Tecnomobele-FGA/Modulo-luzes/fotos/detalhes_painel_up.jpg

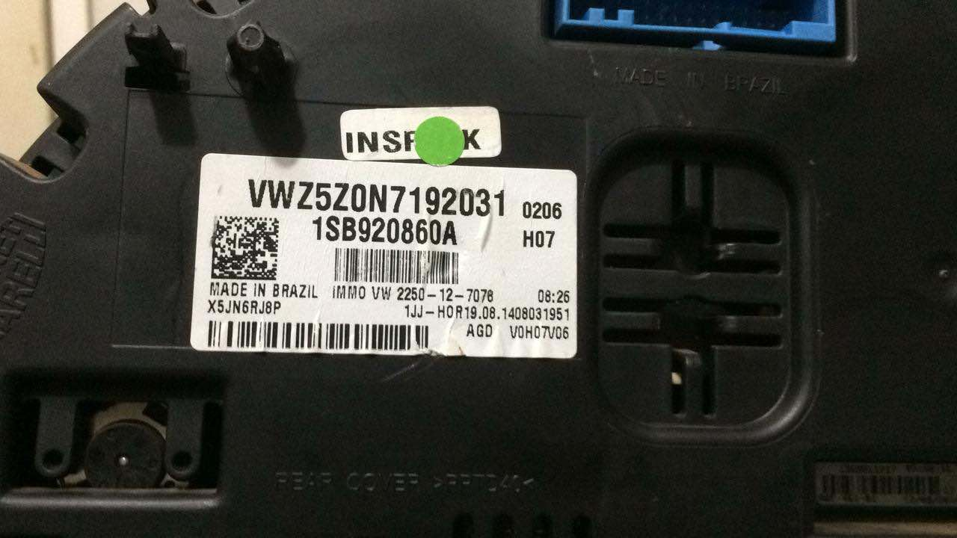
fotos/detalhes_painel_up.jpg
