Tecnomobele-FGA/Modulo-luzes/fotos/painel_up_frente.jpg

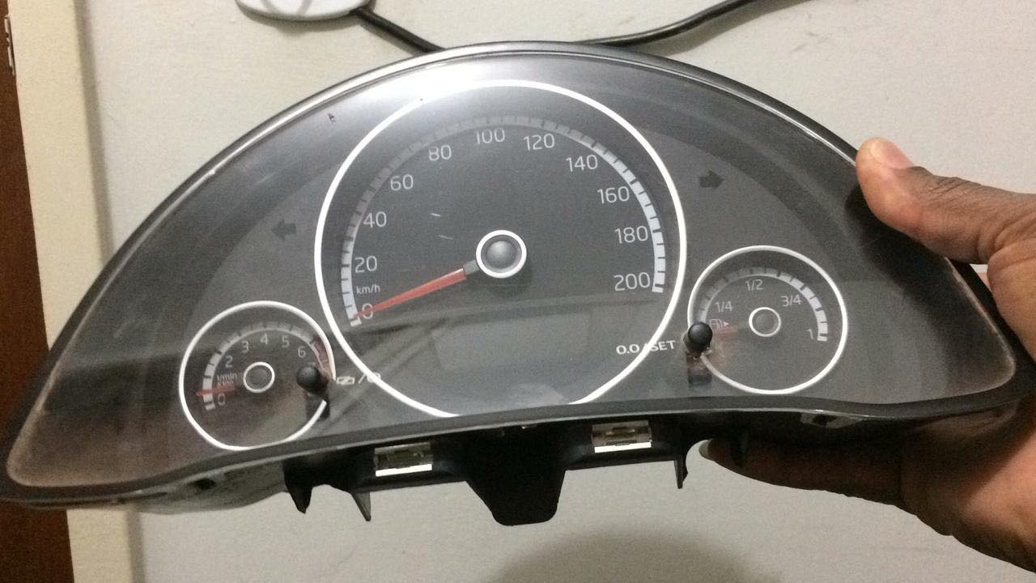
fotos/painel_up_frente.jpg
