Tecnomobele-FGA/Modulo-luzes/fotos/painel_up_fundo.jpg

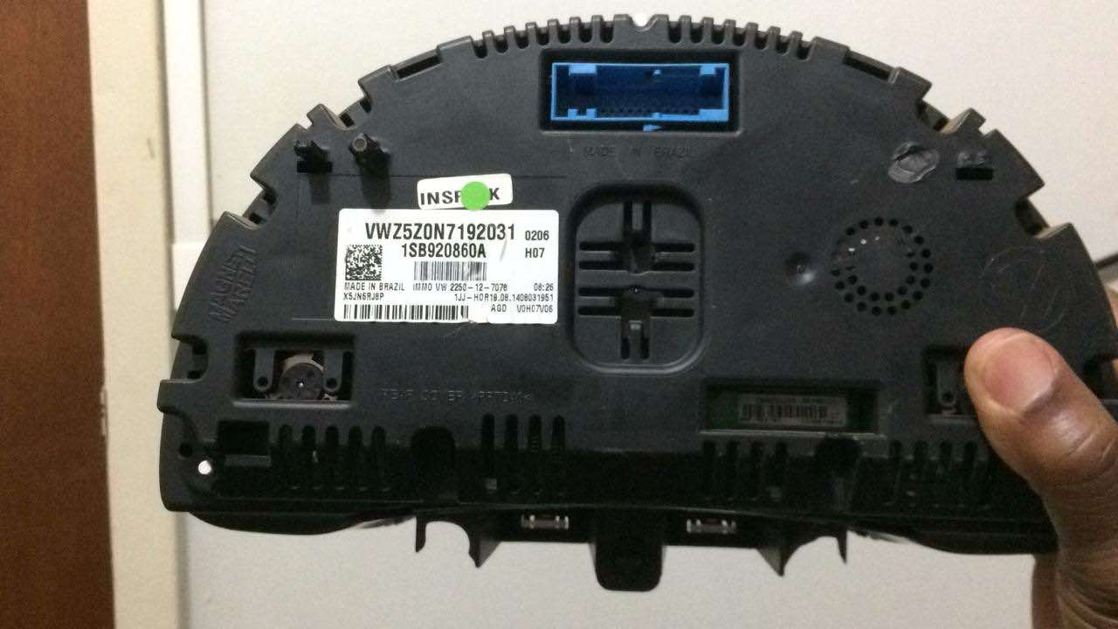
fotos/painel_up_fundo.jpg
