Tecnomobele-FGA/Modulo-luzes/fotos/placa_painel_up.jpg

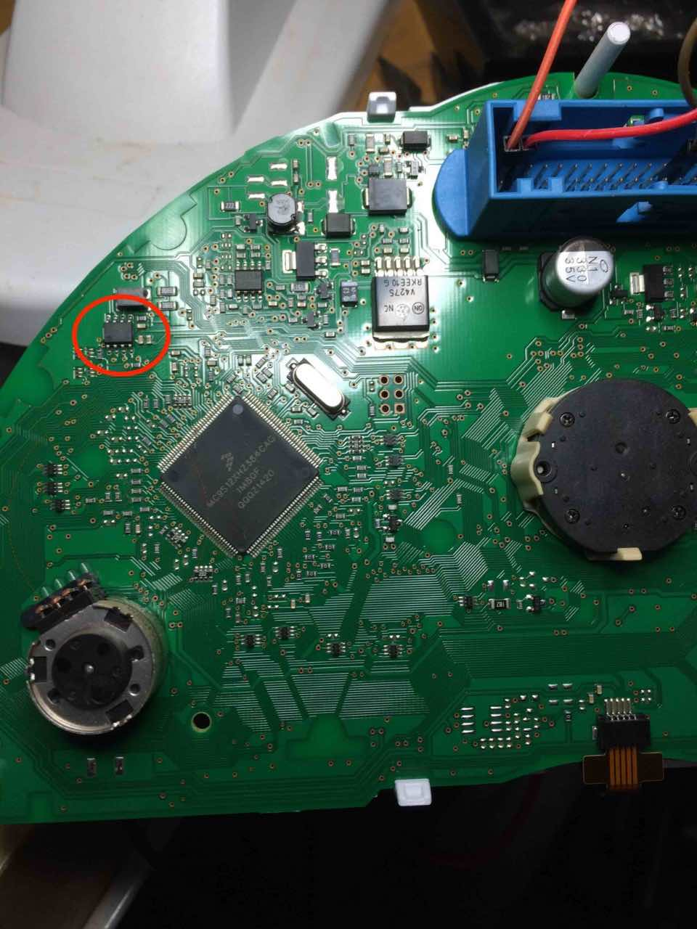
fotos/placa_painel_up.jpg
