Tecnomobele-FGA/Modulo-luzes/fotos/sinal_bloco_1.jpg

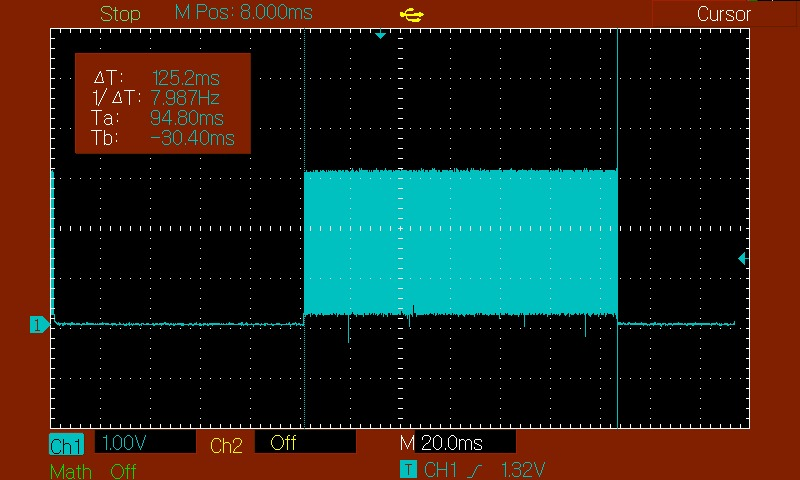
fotos/sinal_bloco_1.jpg
