Tecnomobele-FGA/Modulo-luzes/fotos/sinal_bloco_2.jpg

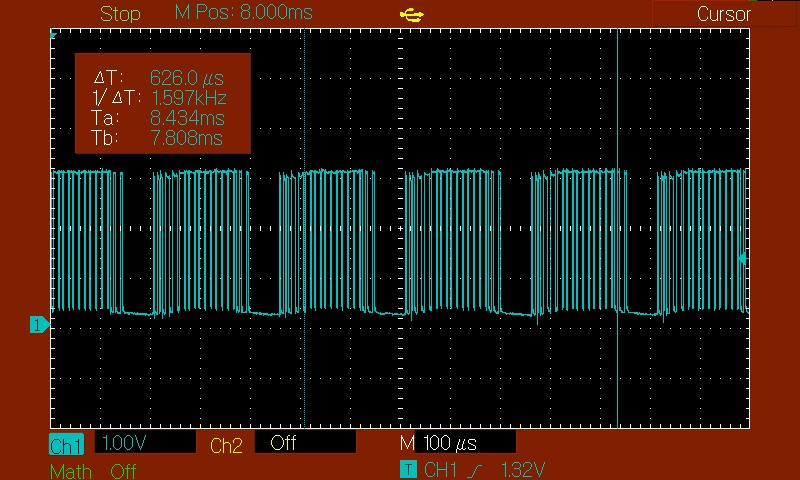
fotos/sinal_bloco_2.jpg
