Tecnomobele-FGA/Modulo-luzes/fotos/sinal_bloco_3.jpg

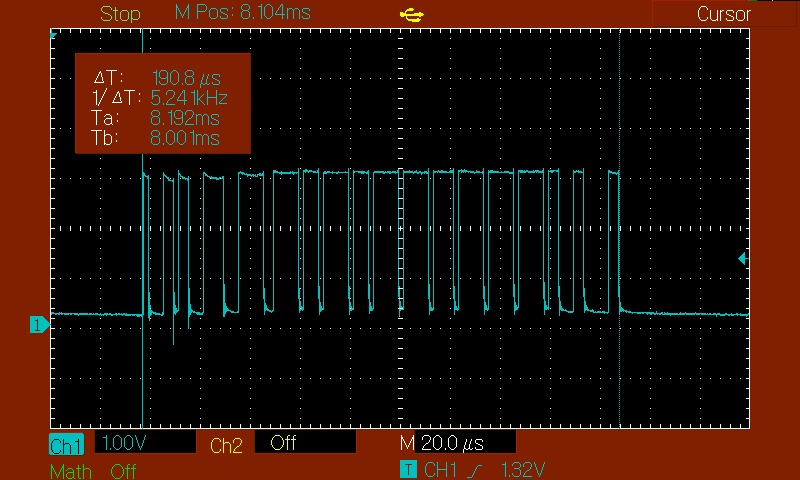
fotos/sinal_bloco_3.jpg
