Tecnomobele-FGA/Modulo-luzes/fotos/sinal_can_sem_terminador.jpg

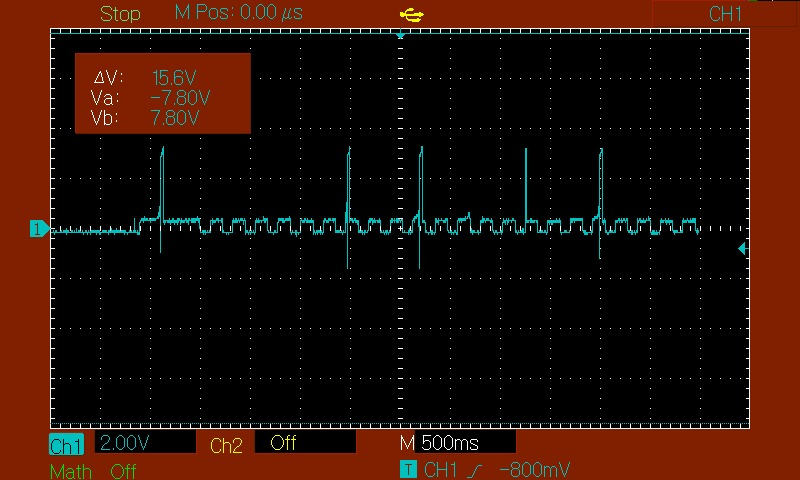
fotos/sinal_can_sem_terminador.jpg
