Tecnomobele-FGA/Modulo-luzes/fotos/sinal_can_terminador.jpg

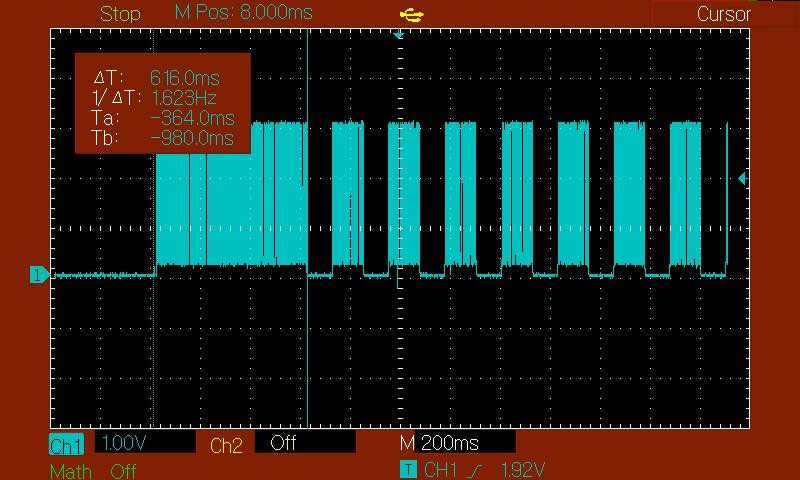
fotos/sinal_can_terminador.jpg
