Tecnomobele-FGA/Modulo-luzes/Codes/ModulodeLuzes.ino

/*
  Programa para executar os comandos da sinalizacao do BREletrico
  Placa Arduino Mega instalada em baixo do painel do veiculo
  A sinalizacao dos comandos no LCD sao:
  - setaDireitaOn();
  - setaDireitaOff();
  - setaEsquerdaOn();
  - setaEsquerdaOff();
  - farolBaixo();
  - farolAlto();
  - freioDeMao();
  - bateria();
  2018/09/15 - Primeira versão com Arduino Mega 
  2020/11/22 - Nova placa com Arduino Nano - MCP2551             
               Testando funcionalidades Display ok, beep ok 
               Falta testar entradas e saidas
  2020/12/15 - Iniciando uso de CANbus      
               Can bus funcionando - testado com painel UP 
  2020/01/29 - Testando luzes no conector e 
               Falta o reset do display
               
  2021/03/17 - Implementacao das chaves de sinalizacao do veiculo atraves do MUX 
                     
*/

#include <Canbus.h>
#include <defaults.h>
#include <global.h>
#include <mcp2515.h>
#include <mcp2515_defs.h>

//----------- PINOS DO DISPLAY LCD------------------------------
#define  lcd_RS     7    // D7
#define  lcd_RW     8    // D8
#define  lcd_E      9    // D9
#define  beep       6    // D6 

//----------- PINOS DO SHIFT REGISTER 74HC595-------------------

#define SR_RCLK     3    // D3 storage reg clock
#define SR_SRCLK    4    // D4 shift reg clock
#define SR_SER      5    // D5 serial data input

//--------PINOS DE ENTRADA DAS CHAVES DE SINALIZACAO DO VEICULO----

#define SEL         A6   // Porta da seletora do MUX
#define In_Setas    A0   // Entradas das setas esquerdas e direitas
#define In_Farois   A1   // Entradas dos farois - Alto e Baixo
#define In_LanAl    A2   // Entradas do Alerta e lanterna
#define In_Freios   A3   // Entrada do ferio e freio de mao
#define In_Re       A4   // Entrada re

//---FUNCAO PARA ESCREVER A SAIDA DAS LUZES DE SINALIZACAO ATRAVES DO REGISTRADOR DE DESLOGAMENTO-------------  

void escreve74595(byte a)
{
  byte b;
  b= a;
  digitalWrite(SR_RCLK,0);
  digitalWrite(SR_SRCLK,0);
  digitalWrite(SR_SER,0);
  if ((b && 0x01)==0x01) digitalWrite(SR_SER,1); else digitalWrite(SR_SER,0);        // 0x01
  digitalWrite(SR_SRCLK,1);
  digitalWrite(SR_SRCLK,0);
  if (((b >> 1) && 0x01)==0x01) digitalWrite(SR_SER,1); else digitalWrite(SR_SER,0); // 0x02
  digitalWrite(SR_SRCLK,1);
  digitalWrite(SR_SRCLK,0);
  if (((b >> 1) && 0x01)==0x01) digitalWrite(SR_SER,1); else digitalWrite(SR_SER,0); // 0x04
  digitalWrite(SR_SRCLK,1);
  digitalWrite(SR_SRCLK,0);
  if (((b >> 1) && 0x01)==0x01) digitalWrite(SR_SER,1); else digitalWrite(SR_SER,0); // 0x08
  digitalWrite(SR_SRCLK,1);
  digitalWrite(SR_SRCLK,0);
  if (((b >> 1) && 0x01)==0x01) digitalWrite(SR_SER,1); else digitalWrite(SR_SER,0); // 0x10  
  digitalWrite(SR_SRCLK,1);
  digitalWrite(SR_SRCLK,0);
  if (((b >> 1) && 0x01)==0x01) digitalWrite(SR_SER,1); else digitalWrite(SR_SER,0); // 0x20
  digitalWrite(SR_SRCLK,1);
  digitalWrite(SR_SRCLK,0);
  if (((b >> 1) && 0x01)==0x01) digitalWrite(SR_SER,1); else digitalWrite(SR_SER,0); // 0x40
  digitalWrite(SR_SRCLK,1);
  digitalWrite(SR_SRCLK,0);
  if (((b >> 1) && 0x01)==0x01) digitalWrite(SR_SER,1); else digitalWrite(SR_SER,0); // 0x80
  digitalWrite(SR_SRCLK,1);
  digitalWrite(SR_SRCLK,0);
  digitalWrite(SR_RCLK,1);   // serial to paralelel 
  digitalWrite(SR_RCLK,0);    
}



#include "U8glib.h"
#include "MsTimer2.h"

char versao[10]="17mar21";

U8GLIB_ST7920_128X64_4X u8g(lcd_E , lcd_RW, lcd_RS );  // Enable, RW, RS, RESET
// D7 = RS
// D8 = R/W
// D9 = E
// Falta implementar Reset no Shiftrefister

//--------------VARIAVEIS GLOBAIS----------------------------

boolean PinFarolBaixa ;  
boolean PinFarolAlta  ;
boolean PinLanterna   ;  
boolean PinLuzDeFreio ;  
boolean PinLuzRe      ;   
boolean PinSetaDireita;  
boolean PinSetaEquerda;  


//-----------------VARIAVEIS GLOBAIS QUE DEFINEM O ESTADO DAS LUZES-----------------------
boolean SEL_aux =0;
boolean BpiscaAlerta = 0;
boolean BsetaEsquerda = 0;
boolean BsetaDireita = 0;
boolean BfarolBaixo = 0;
boolean BfarolAlto = 0;
boolean Blanterna = 0;
boolean BluzDeRe = 0;
boolean BluzDeFreio = 0;
boolean BluzDeMao = 0;
boolean BluzRe = 0;

boolean pisca_on;

//------MATRIZ DE DESENHO DO SIMBOLO DO FAROL BAIXO-----------------   

void LigaFarolBaixo() {
  boolean farol[][20] {
    {0, 0, 0, 0, 0, 0, 0, 0, 0, 0, 0, 0, 0},
    {0, 0, 1, 1, 1, 1, 1, 0, 0, 0, 0, 0, 0},
    {0, 0, 1, 1, 1, 1, 1, 1, 0, 0, 0, 0, 0},
    {0, 1, 0, 0, 0, 0, 0, 1, 1, 1, 0, 0, 0},
    {0, 1, 0, 0, 0, 0, 0, 0, 0, 1, 1, 0, 0},
    {1, 1, 0, 0, 0, 0, 0, 0, 0, 0, 1, 1, 0},
    {1, 1, 0, 0, 0, 0, 0, 0, 0, 0, 0, 1, 0},
    {1, 1, 0, 0, 0, 0, 0, 0, 0, 0, 0, 1, 1},
    {1, 1, 0, 0, 0, 0, 0, 0, 0, 0, 0, 0, 1},
    {1, 1, 0, 0, 0, 0, 0, 0, 0, 0, 0, 0, 1},
    {1, 1, 0, 0, 0, 0, 0, 0, 0, 0, 0, 0, 1},
    {1, 1, 0, 0, 0, 0, 0, 0, 0, 0, 0, 0, 1},
    {1, 1, 0, 0, 0, 0, 0, 0, 0, 0, 0, 1, 1},
    {1, 1, 0, 0, 0, 0, 0, 0, 0, 0, 0, 1, 0},
    {0, 1, 0, 0, 0, 0, 0, 0, 0, 0, 1, 1, 0},
    {0, 1, 0, 0, 0, 0, 0, 0, 0, 1, 1, 0, 0},
    {0, 1, 0, 0, 0, 0, 0, 1, 1, 1, 0, 0, 0},
    {0, 0, 1, 1, 1, 1, 1, 1, 0, 0, 0, 0, 0},
    {0, 0, 1, 1, 1, 1, 1, 0, 0, 0, 0, 0, 0},
    {0, 0, 0, 0, 0, 0, 0, 0, 0, 0, 0, 0, 0}
  };
  
  // farol baixo
  int baixo = 2;
  int dX = 50;
  int dY = 40;
  
  for ( int x = 0; x < 13; x++)
    for ( int y = 0; y < 20; y++)
      if (farol[y][x] == 1)
        u8g.drawPixel(x + dX + 10, y + dY);
  u8g.drawLine(1 + dX, 1 + dY + baixo, 9 + dX, 1 + dY);
  u8g.drawLine(1 + dX, 5 + dY + baixo, 8 + dX, 5 + dY);
  u8g.drawLine(1 + dX, 10 + dY + baixo, 7 + dX, 10 + dY);
  u8g.drawLine(1 + dX, 15 + dY + baixo, 8 + dX, 15 + dY);
  u8g.drawLine(1 + dX, 19 + dY + baixo, 9 + dX, 19 + dY);
}

void LigaFarolAlto() {

//------MATRIZ DE DESENHO DO SIMBOLO DO FAROL ALTO-----------------   
  boolean farol[][20] {
    {0, 0, 0, 0, 0, 0, 0, 0, 0, 0, 0, 0, 0},
    {0, 0, 1, 1, 1, 1, 1, 0, 0, 0, 0, 0, 0},
    {0, 0, 1, 1, 1, 1, 1, 1, 0, 0, 0, 0, 0},
    {0, 1, 0, 0, 0, 0, 0, 1, 1, 1, 0, 0, 0},
    {0, 1, 0, 0, 0, 0, 0, 0, 0, 1, 1, 0, 0},
    {1, 1, 0, 0, 0, 0, 0, 0, 0, 0, 1, 1, 0},
    {1, 1, 0, 0, 0, 0, 0, 0, 0, 0, 0, 1, 0},
    {1, 1, 0, 0, 0, 0, 0, 0, 0, 0, 0, 1, 1},
    {1, 1, 0, 0, 0, 0, 0, 0, 0, 0, 0, 0, 1},
    {1, 1, 0, 0, 0, 0, 0, 0, 0, 0, 0, 0, 1},
    {1, 1, 0, 0, 0, 0, 0, 0, 0, 0, 0, 0, 1},
    {1, 1, 0, 0, 0, 0, 0, 0, 0, 0, 0, 0, 1},
    {1, 1, 0, 0, 0, 0, 0, 0, 0, 0, 0, 1, 1},
    {1, 1, 0, 0, 0, 0, 0, 0, 0, 0, 0, 1, 0},
    {0, 1, 0, 0, 0, 0, 0, 0, 0, 0, 1, 1, 0},
    {0, 1, 0, 0, 0, 0, 0, 0, 0, 1, 1, 0, 0},
    {0, 1, 0, 0, 0, 0, 0, 1, 1, 1, 0, 0, 0},
    {0, 0, 1, 1, 1, 1, 1, 1, 0, 0, 0, 0, 0},
    {0, 0, 1, 1, 1, 1, 1, 0, 0, 0, 0, 0, 0},
    {0, 0, 0, 0, 0, 0, 0, 0, 0, 0, 0, 0, 0}
  }; 
  // farol alto
  int dX = 50;
  int dY = 40;
  
  for ( int x = 0; x < 13; x++)
    for ( int y = 0; y < 20; y++)
      if (farol[y][x] == 1)
        u8g.drawPixel(x + dX + 10, y + dY);
  u8g.drawLine(1 + dX, 1 + dY, 9 + dX, 1 + dY);
  u8g.drawLine(1 + dX, 5 + dY, 8 + dX, 5 + dY);
  u8g.drawLine(1 + dX, 10 + dY, 7 + dX, 10 + dY);
  u8g.drawLine(1 + dX, 15 + dY, 8 + dX, 15 + dY);
  u8g.drawLine(1 + dX, 19 + dY, 9 + dX, 19 + dY);
}


void SetaDireitaOn()
{
  int dX = 112;
  int dY = 20;
  u8g.drawTriangle(0 + dX, 0 + dY, 0 + dX, 20 + dY, 15 + dX, 10 + dY);
}

void SetaDireitaOff()
{
  int dX = 113;
  int dY = 20;
  u8g.drawLine(0 + dX, 0 + dY, 0 + dX, 20 + dY);
  u8g.drawLine(0 + dX, 0 + dY, 15 + dX, 10 + dY);
  u8g.drawLine(15 + dX, 10 + dY, 0 + dX, 20 + dY);
}

void SetaEsquerdaOn()
{
  int dX = 0;
  int dY = 20;
  u8g.drawTriangle(15 + dX, 0 + dY, 15 + dX, 20 + dY, 0 + dX, 10 + dY); // seta esquerda
}

void SetaEsquerdaOff()
{
  int dX = 0;
  int dY = 20;
  u8g.drawLine(15 + dX, 0 + dY, 15 + dX, 20 + dY);
  u8g.drawLine(15 + dX, 0 + dY, 0 + dX, 10 + dY);
  u8g.drawLine(0 + dX, 10 + dY, 15 + dX, 20 + dY);
}

int temp=0;

void BaseDeTempo(void)
{
 pisca_on =! pisca_on;
 temp++;
 if (temp==5) escreve74595(0); 
 if (temp==10) { escreve74595(0xFF); temp=0;}
}

void beep_on(void)
{ 
  //digitalWrite(beep,HIGH);
  analogWrite(beep, 100);
}

void beep_off(void)
{ 
  digitalWrite(beep,LOW);
}


void setup() {
  pinMode(beep, OUTPUT);

//---------------LUZES DE SAIDA NO SHIFT REGISTER --------------------
  pinMode(SR_RCLK, OUTPUT);
  pinMode(SR_SRCLK, OUTPUT);   
  pinMode(SR_SER, OUTPUT);     

//-------------------CHAVES DE ENTRADA DO VEICULO--------------------------  
  pinMode(SEL, OUTPUT);
  pinMode(In_Setas, INPUT);   
  pinMode(In_Farois, INPUT);
  pinMode(In_LanAl, INPUT);
  pinMode(In_Freios, INPUT);   
  pinMode(In_Re, INPUT);

/*
//-------------------LUZES DO VEICULO--------------------------  

  pinMode(PinSetaDireita, OUTPUT);    //Seta direita
  pinMode(PinSetaEquerda, OUTPUT);    //Seta esquerda
  pinMode(PinFarolBaixa, OUTPUT);     //farol baixo
  pinMode(PinFarolAlta, OUTPUT);      //farol alto
  pinMode(PinLanterna, OUTPUT);       //lanterna
  pinMode(PinLuzDeFreio, OUTPUT);     //freio
  pinMode(PinLuzRe, OUTPUT);          //re

//-------------------CHAVES DO VEICULO---------------------------

  pinMode(InPiscaAlerta, INPUT);      //pisca alerta
  pinMode(InSetaEsquerda, INPUT);     //seta esquerda
  pinMode(InSetaDireita, INPUT);      //seta direita 
  pinMode(InFarolBaixo, INPUT);       //farol baixo
  pinMode(InFarolAlto, INPUT);        //farol alto
  pinMode(InLanterna, INPUT);         //Lanterna
  pinMode(InFreioDeMao, INPUT);       //Freio de mao
  pinMode(InRe,INPUT);                //Re
*/
 

  /* display grafico */
  if ( u8g.getMode() == U8G_MODE_R3G3B2 ) {
    u8g.setColorIndex(255);     // white
  }
  else if ( u8g.getMode() == U8G_MODE_GRAY2BIT ) {
    u8g.setColorIndex(3);         // max intensity
  }
  else if ( u8g.getMode() == U8G_MODE_BW ) {
    u8g.setColorIndex(1);         // pixel on
  }
  else if ( u8g.getMode() == U8G_MODE_HICOLOR ) {
    u8g.setHiColorByRGB(255, 255, 255);
  }  
  MsTimer2::set(500, BaseDeTempo);
  MsTimer2::start();
  Serial.begin(9600);
  while (!Serial) {
    ; // wait for serial port to connect. Needed for native USB port only
  }
  Serial.println("BREletrica CAN Luzes 15/12/2020");
  beep_on();
  u8g.firstPage();
  do {
    u8g.setFont(u8g_font_unifont);
    u8g.drawStr(20, 20, "BREletrico");      
    u8g.drawStr(30, 54, versao);
  } while (u8g.nextPage());
  delay(500);
  
  beep_off();
  Serial.println("CAN Read - Testing receival of CAN Bus message");  
  delay(500);
  
  if(Canbus.init(CANSPEED_500))  //Initialise MCP2515 CAN controller at the specified speed
    Serial.println("CAN Init ok");
  else
    Serial.println("Can't init CAN");
    
  delay(1000);

  BfarolAlto = 1; 
}

/*
void SequencialLuzes(void) {
  PinSetaDireita=1; delay(1000); PinSetaDireita=0; delay(1000);
  PinSetaEquerda=1; delay(1000); PinSetaEquerda=0; delay(1000);
  PinFarolBaixa=1;  delay(1000); PinFarolBaixa=0;  delay(1000);
  PinFarolAlta=1;   delay(1000); PinFarolAlta=0;   delay(1000);
  PinLanterna=1;    delay(1000); PinLanterna=0;    delay(1000);
  PinLuzDeFreio=1;  delay(1000); PinLuzDeFreio=0;  delay(1000);
  PinLuzRe=1;       delay(1000); PinLuzRe=0;       delay(1000);
}*/

//---FUNCAO PARA LER AS CHAVES DO VEICULO--------------------------
void Leia_Chaves(void) {
  
  byte x;
  
  if(SEL_aux = '0'){ 
    BpiscaAlerta = analogRead(In_LanAl);
    BsetaDireita = analogRead(In_Setas);
    BfarolAlto = analogRead(In_Farois);
    BluzDeMao = analogRead(In_Freios);
    BluzDeRe = analogRead(In_Re);
    analogWrite(SEL,HIGH);
    SEL_aux ='1';
  }else{  
    Blanterna = analogRead(In_LanAl);
    BsetaEsquerda = analogRead(In_Setas);
    BfarolBaixo = analogRead(In_Farois);
    BluzDeFreio = analogRead(In_Freios);
    analogWrite(SEL,LOW);
    SEL_aux ='0';
  }


    
  x= BpiscaAlerta*B10000000+BsetaEsquerda*B01000000+BsetaDireita*B00100000+BfarolBaixo*B00010000+BfarolAlto*B00001000+Blanterna*B00000100+BluzDeRe*B00000010+BluzDeFreio*B00000001;
    
  Serial.print(x,BIN);
  Serial.println(" Entradas ");

  escreve74595(x);
  
//  char inChar;
//  if (Serial.available()) {
//   inChar = (char)Serial.read();
//   Serial.print(" Valor = ");Serial.print(inChar);
//   switch (inChar){
//    case '0':  BpiscaAlerta = 0; //digitalRead(InPiscaAlerta);
//               BsetaEsquerda = 0; // digitalRead(InSetaEsquerda);
//               BsetaDireita = 0; //digitalRead(InSetaDireita);
//               BfarolBaixo = 0; // digitalRead(InFarolBaixo);
//               BfarolAlto = 0; //digitalRead(InFarolAlto);
//               Blanterna = 0;  //digitalRead(InLuzAlta);
//               BluzDeRe = 0; //digitalRead(InFreioDeMao);
//               BluzDeFreio = 0; //digitalRead(InLuzDeFreio);
//               break;
//    case '1':  BpiscaAlerta = 1; break; // Blaterna
//    case '2':  BfarolBaixo = 1; break; //setaEsquerda = 1; break;
//    case '3':  BsetaDireita = 1; break;
//    case '4':  BsetaEsquerda = 1; break; //farolBaixo = 1; break;
//    case '5':  BfarolAlto = 1; break;
//    case '6':  Blanterna = 1;  break;
//    case '7':  BluzDeRe = 1; break;
//    case '8':  BluzDeFreio = 1; break;
//    default: break;
//    }
//  } 

  //BpiscaAlerta = 1; //digitalRead(InPiscaAlerta);
  //BsetaEsquerda = 1; // digitalRead(InSetaEsquerda);
  //BsetaDireita = 1; //digitalRead(InSetaDireita);
  //BfarolBaixo = 1; // digitalRead(InFarolBaixo);
  //BfarolAlto = 1; //digitalRead(InFarolAlto);
  //Blanterna = 1;  //digitalRead(InLuzAlta);
  //BluzDeRe = 1; //digitalRead(InFreioDeMao);
  //BluzDeFreio = 1; //digitalRead(InLuzDeFreio);*/
  
}

void draw() {
  // graphic commands to redraw the complete screen should be placed here  
  // comandos simultaneamento no LCD e na Sinalizacao  
  if (BfarolBaixo) {LigaFarolBaixo(); PinFarolBaixa=1; } else PinFarolBaixa=0;
  if (BfarolAlto) {LigaFarolAlto(); PinFarolAlta=1;  } else PinFarolAlta=0;  
  if (Blanterna) { PinLanterna=1; } else { PinLanterna=0; }
  if (BluzDeFreio) { PinLuzDeFreio=1; } else { PinLuzDeFreio=1;}
  if (BluzRe) { PinLuzRe=1;} else { PinLuzRe=0; }
  
  // comandos somente no LCD
  if (BluzDeRe) {;}

  // comandos temporizados no LCD e na sinalizacao
  if (BpiscaAlerta) 
  { 
   if (pisca_on) 
   {
    SetaEsquerdaOn();  SetaDireitaOn(); PinSetaEquerda=1; PinSetaDireita=1; beep_on(); }
    else 
   { 
    SetaEsquerdaOff(); SetaDireitaOff();PinSetaEquerda=0; PinSetaDireita=0; beep_off(); }
  }
   else {SetaEsquerdaOff(); SetaDireitaOff();PinSetaEquerda=0; PinSetaDireita=0; beep_off();}
     
  if (BsetaEsquerda) 
  { 
    if (pisca_on) {SetaEsquerdaOn(); PinSetaEquerda=1; } else { SetaEsquerdaOff(); PinSetaEquerda=0;}
  } 
   else  { SetaEsquerdaOff(); PinSetaEquerda=0;}
  if (BsetaDireita) 
  { 
    if (pisca_on) {SetaDireitaOn();PinSetaDireita=1; } else { SetaDireitaOff(); PinSetaDireita=0;} 
  } else { SetaDireitaOff(); PinSetaDireita=0;}
}

void loop() {
  // SequencialLuzes();   //
  tCAN message;
  Leia_Chaves();
  u8g.firstPage();
  do {
    draw();
  } while ( u8g.nextPage() );
  }

  /* rotinas de leitura CAN 
  if (mcp2515_check_message()) 
  {
    if (mcp2515_get_message(&message)) 
    {
               Serial.print("ID: ");
               Serial.print(message.id,HEX);
               Serial.print(", ");
               Serial.print("Data: ");
               Serial.print(message.header.length,DEC);
               for(int i=0;i<message.header.length;i++) 
                { 
                  Serial.print(message.data[i],HEX);
                  Serial.print(" ");
                }
               Serial.println("");
     }
   }
  fim rotina leitura CAN */
