Tecnomobele-FGA/Modulo-luzes/(commit log)

2020-06-22 foto placa de controle de luzes
2020-06-22 codigo fonte arduino
2020-11-23 Postando foto montado e link para programa de controle
2021-03-17 Create ModulodeLuzes.ino
    Versão1 - Implementação das chaves de sinalização (luzes) do veiculo com o MUX
